SteveMayze/CurrentSinkOrSwim/README.md

# CurrentSinkOrSwim
Building a Current Sink for Battery Testing in Contextual Electronics.
