SteveMayze/CurrentSinkOrSwim/doc/CSOS-Connection.png

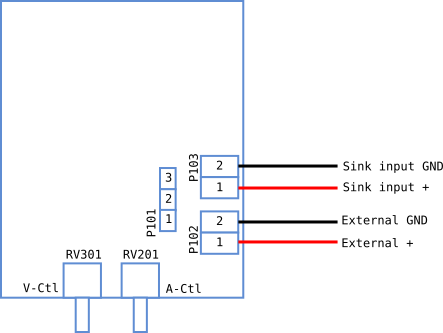
doc/CSOS-Connection.png
