SteveMayze/CurrentSinkOrSwim/image/CurrentSinkOrSwim-brd.png

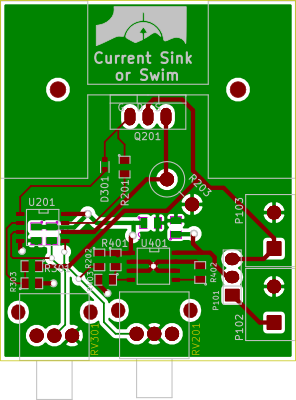
image/CurrentSinkOrSwim-brd.png
