SteveMayze/CurrentSinkOrSwim/ModifiedR302.tiff

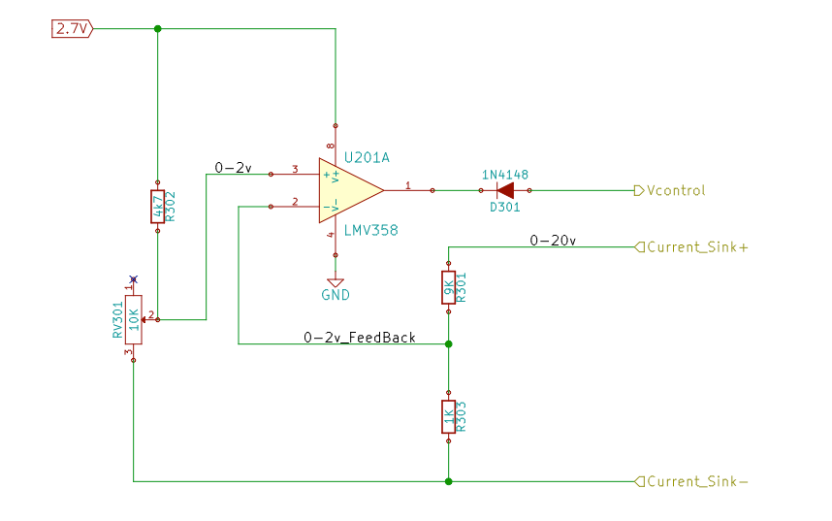
ModifiedR302.tiff
