SteveMayze/CurrentSinkOrSwim/CurrentSinkOrSwim.kicad_pcb

## KiCad design CurrentSinkOrSwim.kicad_pcb (2020-09-26)

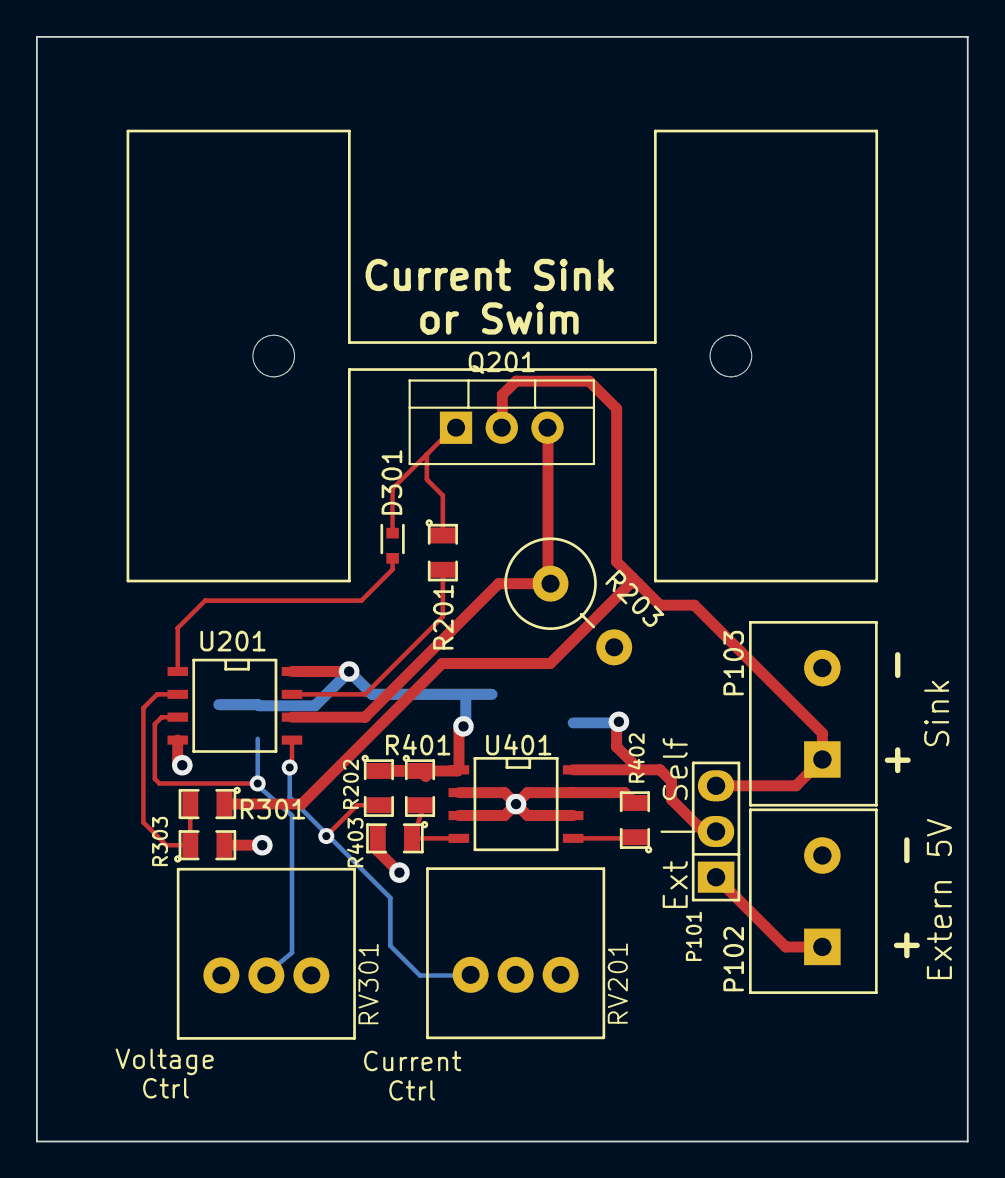
[picture p8: board CurrentSinkOrSwim.kicad_pcb from above]

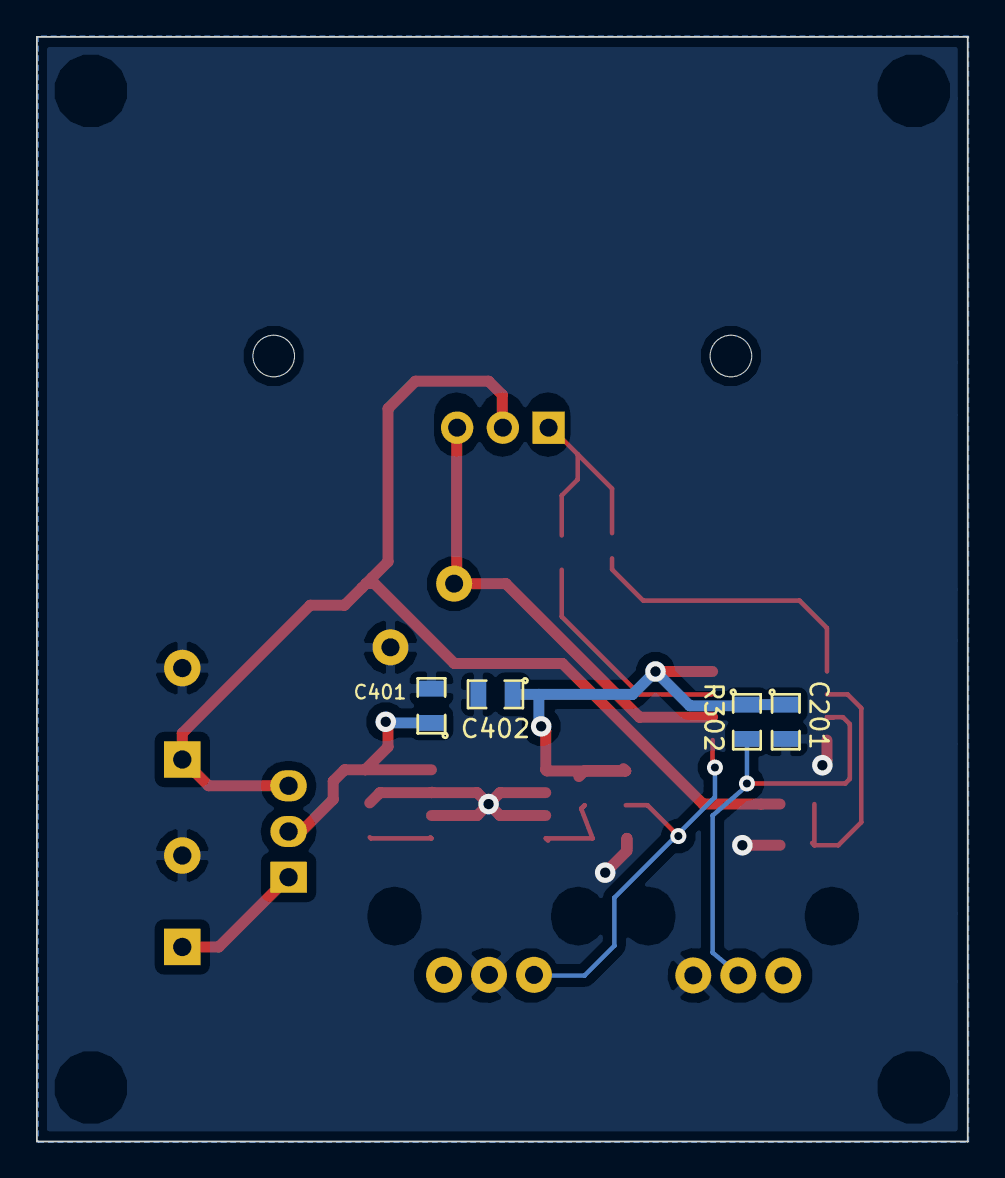
[picture p9: board CurrentSinkOrSwim.kicad_pcb from below]

Board: 2 copper layers, 51.7 x 61.4 mm, 22 parts (4 on the bottom side), 14 nets.

Parts:
C201, C401, C402: 0.1uF; SMD-0805
D301: 1N4148; SOD-523
P101: CONN_01X03; Pin_Header_Straight_1x03
P102, P103: CONN_01X02; Terminal_Block_1x200_mil
P201: HEATSINK; FA-220-38E
Q201: BUK9575; TO-220-3_Vertical
R201, R303: 1K; SMD-0805
R202: 68K; SMD-0805
R203: .1; Resistor_Vertical_RM5mm
R301: 9K; SMD-0805
R302: 28k7; SMD-0805
R401: 27k; SMD-0805
R402: 0; SMD-0805
R403: 21.6k; SMD-0805
RV201, RV301: 10k; P090L-02F25BR10K
U201: LMV358; SOIC-8-N
U401: LM2931D-R; SOIC-8-N

Connections:
2.7V: C201.1, C402.1, R202.1, R302.1, R401.1, U201.8, U401.1
/Current Control/Current_Sink+: P101.3, P103.1, Q201.2, R301.1
/Current Control/FET_GATE: D301.2, Q201.1, R201.1
/Power Regulation/Vin: C401.1, P101.2, U401.8
/Voltage Control/0-2v: R302.2, RV301.2, U201.3
/Voltage Control/0-2v_FeedBack: R301.2, R303.1, U201.2
GND: C201.2, C401.2, C402.2, P102.2, P103.2, R203.2, R303.2, R402.2, R403.2, RV201.2, RV301.3, U201.4, U401.2, U401.3, U401.6, U401.7
unnamed: D301.1, U201.1
unnamed: P101.1, P102.1
unnamed: Q201.3, R203.1, U201.6
unnamed: R201.2, U201.7
unnamed: R202.2, RV201.1, U201.5
unnamed: R401.2, R403.1, U401.4
unnamed: R402.1, U401.5
