SteveMayze/CurrentSinkOrSwim/doc/CSOS-Results.pdf

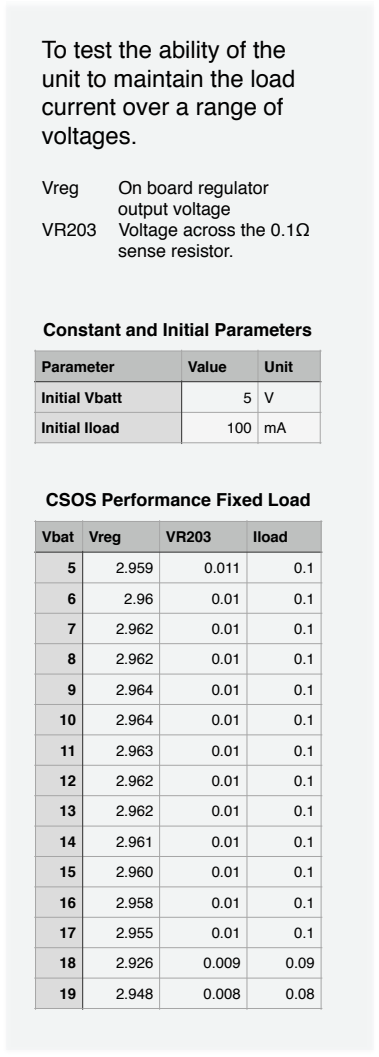
[picture p10: figure]
CSOS Performance Fixed Load; Vbat; Vreg; Iload; Constant and Initial Parameters; Parameter; Value; Unit; Initial Vbatt; Initial Iload; To test the ability of the unit to maintain the load current over a range of voltages.; On board regulator; output voltage; Voltage across the 0.1Ω; sense resistor.

Maximim Load @ 5V

IMax | 3.09 | A
VR203 | 0.357 | V

0.01

0.1

1

10

5 | 6 | 7 | 8 | 9 | 10 | 11 | 12 | 13 | 14 | 15 | 16 | 17 | 18 | 19
Vreg | VR203 | Iload

## Constant Current - Self Powered Configuration

Voltage Control @ 5Vbatt.

Iload | VRV301 | Vref U201A (Pin2)
0.1 | 1.875 | 0.522
0.09 | 0.572 | 0.497
0.08 | 0.533 | 0.497
0.07 | 0.475 | 0.497
0.06 | 0.429 | 0.497
0.01 | 0.393 | 0.497
0.01 | 0 | 0.497

Voltage Control @ 10Vbatt

Iload | VRV301 | Vref U201A (Pin2)
0.1 | 1.964 | 0.992
0.09 | 1.132 | 0.992
0.08 | 1.017 | 0.992
0.07 | 0.979 | 0.992
0.06 | 0.890 | 0.992
0.5 | 0.846 | 0.992
0.03 | 0.806 | 0.992
0.01 | 0.791 | 0.992
0.01 | 0 | 0.992

Voltage Control @ 15Vbatt

Iload | VRV301 | Vref U201A (Pin2)
0.1 | 1.963 | 1.486
0.09 | 1.72 | 1.486
0.08 | 1.630 | 1.487
0.07 | 1.483 | 1.487
0.06 | 1.38 | 1.487
0.5 | 1.296 | 1.487
0.01 | 1.181 | 1.487
0.01 | 0 | 1.487

0

0.5

1

1.5

2

0.1 | 0.09 | 0.08 | 0.07 | 0.06 | 0.01 | 0.01
VRV301 | Vref U201A (Pin2)

0

0.5

1

1.5

2

0.1 | 0.09 | 0.08 | 0.07 | 0.06 | 0.5 | 0.03 | 0.01 | 0.01
VRV301 | Vref U201A (Pin2)

0

0.5

1

1.5

2

0.1 | 0.09 | 0.08 | 0.07 | 0.06 | 0.5 | 0.01 | 0.01
VRV301 | Vref U201A (Pin2)

## Voltage control cut off - Self Powered Configuration

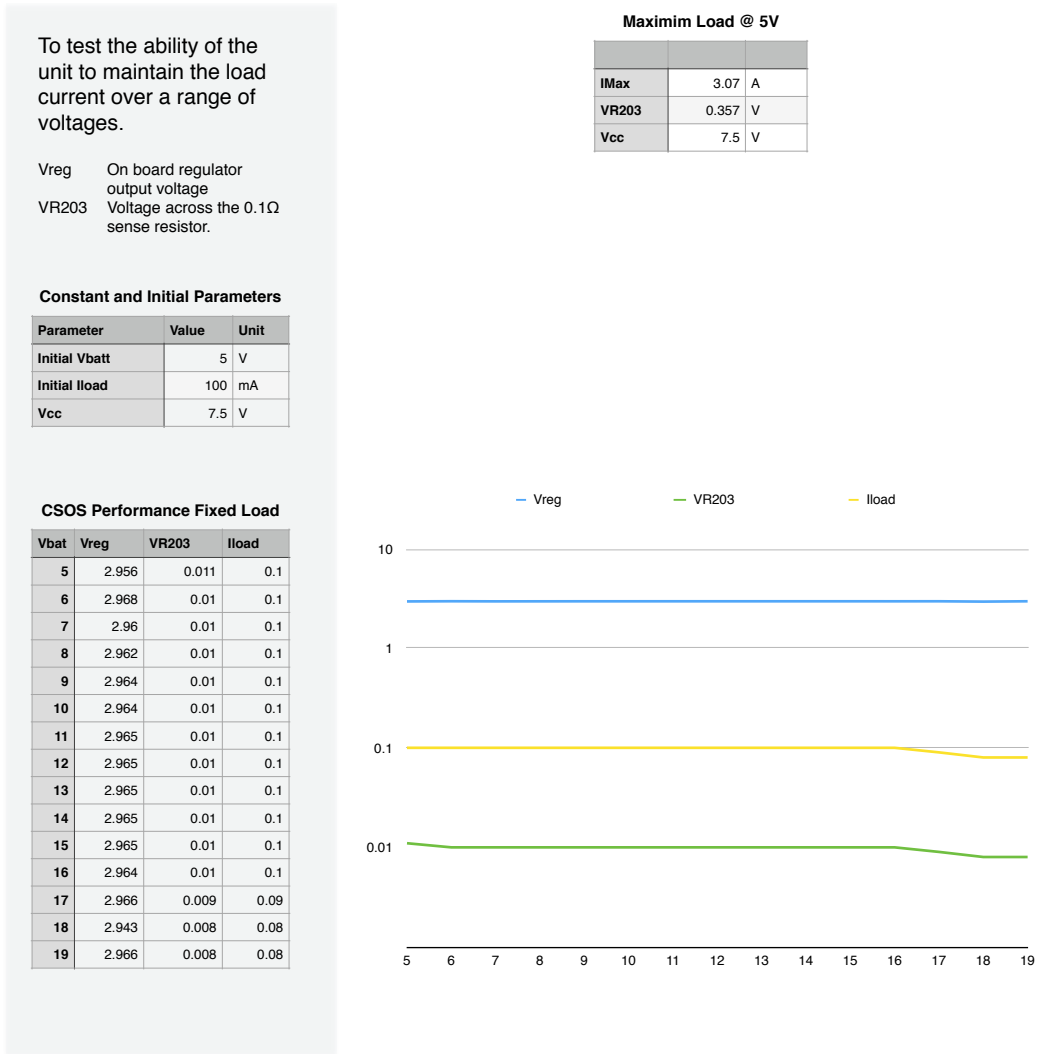
[picture p11: figure]
CSOS Performance Fixed Load; Vbat; Vreg; Iload; Constant and Initial Parameters; Parameter; Value; Unit; Initial Vbatt; Initial Iload; Vcc; To test the ability of the unit to maintain the load current over a range of voltages.; On board regulator; output voltage; Voltage across the 0.1Ω; sense resistor.

Maximim Load @ 5V

IMax | 3.07 | A
VR203 | 0.357 | V
Vcc | 7.5 | V

## Constant Current - External Powered Configuration

Voltage Control @ 5Vbatt.

Iload | VRV301 | Vref U201A (Pin2)
0.1 | 1.877 | 0.522
0.09 | 0.571 | 0.498
0.08 | 0.531 | 0.497
0.07 | 0.469 | 0.497
0.06 | 0.445 | 0.497
0 | 0.381 | 0.497
0 | 0 | 0.497

Voltage Control @ 10Vbatt

Iload | VRV301 | Vref U201A (Pin2)
0.1 | 1.964 | 0.993
0.09 | 1.136 | 0.992
0.08 | 1.078 | 0.992
0.07 | 0.998 | 0.992
0.06 | 0.926 | 0.992
0.5 | 0.871 | 0.992
0 | 0.784 | 0.992
0 | 0 | 0.992

Voltage Control @ 15Vbatt

Iload | VRV301 | Vref U201A (Pin2)
0.1 | 1.967 | 1.487
0.09 | 1.714 | 1.487
0.08 | 1.616 | 1.487
0.07 | 1.439 | 1.487
0.06 | 1.389 | 1.487
0.5 | 1.279 | 1.487
0 | 1.123 | 1.487
0 | 0 | 1.487

0

0.5

1

1.5

2

0.1 | 0.09 | 0.08 | 0.07 | 0.06 | 0 | 0
VRV301 | Vref U201A (Pin2)

0

0.5

1

1.5

2

0.1 | 0.09 | 0.08 | 0.07 | 0.06 | 0.5 | 0 | 0
VRV301 | Vref U201A (Pin2)

0

0.5

1

1.5

2

0.1 | 0.09 | 0.08 | 0.07 | 0.06 | 0.5 | 0 | 0
VRV301 | Vref U201A (Pin2)

## Voltage control cut off - External Powered Configuration
