SteveMayze/CurrentSinkOrSwim/doc/CSOS-Test-Results.numbers/preview-web.jpg

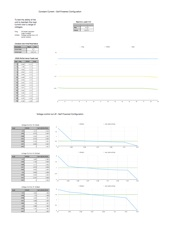
doc/CSOS-Test-Results.numbers/preview-web.jpg
