SteveMayze/CurrentSinkOrSwim/(commit log)

2015-02-01 KiCad project and schematic creation
    [CurrentSinkOrSwim.sch]
2015-02-01 Added inital placements of components onto the PCB
    [CurrentSinkOrSwim.sch]
2015-02-03 Corrections to schematic and .gitignore
    [CurrentSinkOrSwim.sch]
2015-02-17 Small adjustments
    [CurrentSinkOrSwim.sch]
2015-02-17 Caught up with video 18 - Linear Regulator
    [CurrentSinkOrSwim.sch]
2015-02-17 Adding hierarchical sheets and voltage control circuit - Catching up with video 21
    [CurrentControl.sch, CurrentSinkOrSwim.sch, PowerRegulation.sch, VoltageControl.sch]
2015-02-17 Small correction
    [CurrentSinkOrSwim.sch]
2015-02-17 Initial annotation
    [CurrentControl.sch, CurrentSinkOrSwim.sch, PowerRegulation.sch, VoltageControl.sch]
2015-02-17 Preliminary footprint association
    [CurrentControl.sch, CurrentSinkOrSwim.kicad_pcb, CurrentSinkOrSwim.sch, PowerRegulation.sch, VoltageControl.sch]
2015-02-20 Rough board layout
    [CurrentControl.sch, CurrentSinkOrSwim.kicad_pcb]
2015-02-23 Updated the POT references and schematic
    [CurrentControl.sch, CurrentSinkOrSwim.kicad_pcb, CurrentSinkOrSwim.sch, VoltageControl.sch]
2015-02-23 Initial layout
    [CurrentSinkOrSwim.kicad_pcb]
2015-02-26 First cut of layout in preperation for the final session
    [CurrentControl.sch, CurrentSinkOrSwim.kicad_pcb, CurrentSinkOrSwim.sch, PowerRegulation.sch, VoltageControl.sch]
2015-03-02 Routing and fixing schematic checkpoint
    [CurrentControl.sch, CurrentSinkOrSwim.kicad_pcb, CurrentSinkOrSwim.sch, PowerRegulation.sch, VoltageControl.sch]
2015-03-02 Initial route before filling the ground plane
    [CurrentControl.sch, CurrentSinkOrSwim.kicad_pcb, CurrentSinkOrSwim.sch, PowerRegulation.sch, VoltageControl.sch]
2015-03-02 Routed and filled board
    [CurrentSinkOrSwim.kicad_pcb]
2015-03-02 Added logo and fixed 3d view
    [CurrentSinkOrSwim.kicad_pcb]
2015-03-02 Gerber file creation
    [CurrentSinkOrSwim-B_Cu.gbr, CurrentSinkOrSwim-B_Mask.gbr, CurrentSinkOrSwim-B_SilkS.gbr, CurrentSinkOrSwim-Edge_Cuts.gbr, CurrentSinkOrSwim-F_Cu.gbr, CurrentSinkOrSwim-F_Mask.gbr, CurrentSinkOrSwim-F_SilkS.gbr, CurrentSinkOrSwim.drl]
2015-03-03 Latest GERBER creation
    [CurrentSinkOrSwim-B_Cu.gbr, CurrentSinkOrSwim-B_Mask.gbr, CurrentSinkOrSwim-B_SilkS.gbr, CurrentSinkOrSwim-Edge_Cuts.gbr, CurrentSinkOrSwim-F_Cu.gbr, CurrentSinkOrSwim-F_Mask.gbr, CurrentSinkOrSwim-F_SilkS.gbr, CurrentSinkOrSwim.drl]
2015-03-04 The gerbers are off to Fab.
    [CurrentSinkOrSwim-B_Cu.gbl, CurrentSinkOrSwim-B_Mask.gbs, CurrentSinkOrSwim-B_SilkS.gbo, CurrentSinkOrSwim-Edge_Cuts.gko, CurrentSinkOrSwim-F_Cu.gtl, CurrentSinkOrSwim-F_Mask.gts, CurrentSinkOrSwim-F_SilkS.gto, CurrentSinkOrSwim.drl]
2015-03-06 Final update to BOM and added the bom XSL script
    [CurrentControl.sch, CurrentSinkOrSwim.csv, CurrentSinkOrSwim.sch, PowerRegulation.sch, VoltageControl.sch]
2015-03-31 Corrected the default symbol changes in KiCad
    [CurrentControl.sch, CurrentSinkOrSwim.sch, PowerRegulation.sch, VoltageControl.sch]
2015-04-10 Added some test results
    [CurrentControl.sch, CurrentSinkOrSwim.sch, PowerRegulation.sch, VoltageControl.sch]
2015-04-12 Published the schematic PDF
2015-09-30 Added 3mm mounting hole and added board improvements
    [CurrentSinkOrSwim.kicad_pcb]
2020-09-15 Updates to the libraries for the lastest KiCad and a small update to the Datasheet
    [CurrentControl-2020-09-15-08-06-09.sch, CurrentSinkOrSwim-2020-09-15-08-06-09.sch, CurrentSinkOrSwim.kicad_pcb, PowerRegulation-2020-09-15-08-06-09.sch, VoltageControl-2020-09-15-08-06-09.sch]
2020-09-26 Parts update
    [CurrentControl.sch, CurrentSinkOrSwim.kicad_pcb]
2020-09-26 Board update and corrections
    [CurrentSinkOrSwim.kicad_pcb]
